HarryXiaoCN/esp32s3-nes-supermini/docs/ui-empty.png

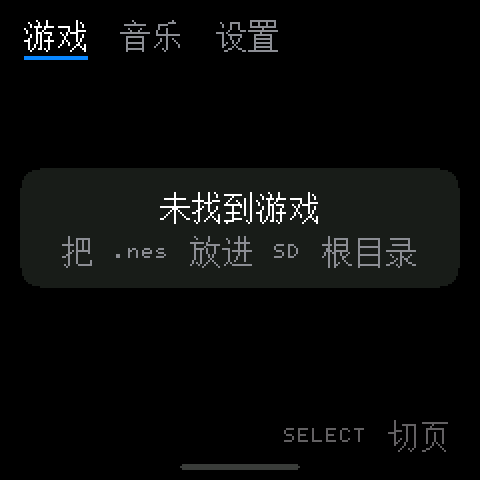
docs/ui-empty.png
