HarryXiaoCN/esp32s3-nes-supermini/docs/ui-lang-en.png

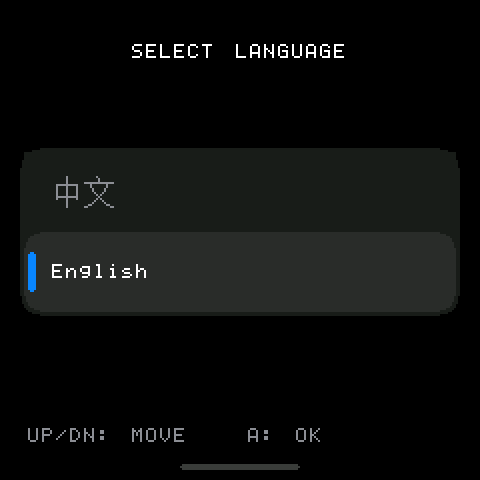
docs/ui-lang-en.png
