HarryXiaoCN/esp32s3-nes-supermini/docs/ui-lang-zh.png

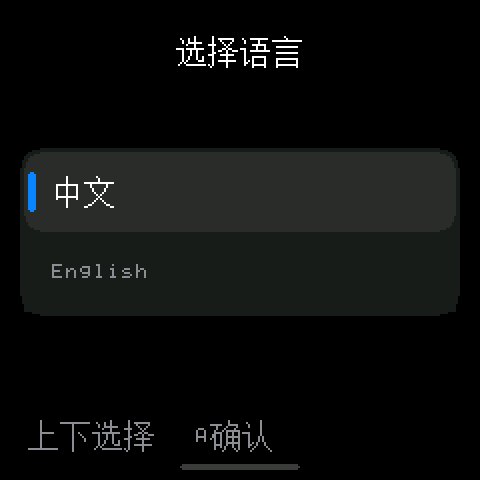
docs/ui-lang-zh.png
