HarryXiaoCN/esp32s3-nes-supermini/docs/ui-menu-en.png

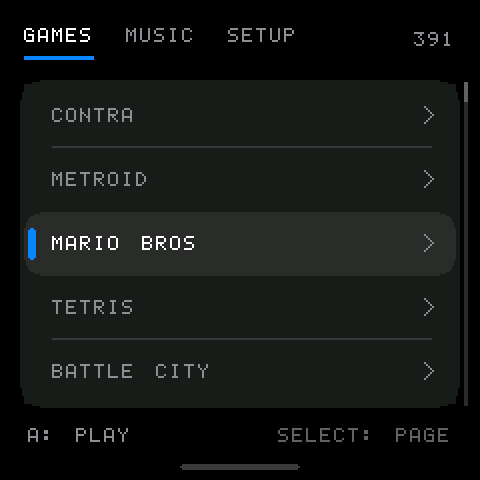
docs/ui-menu-en.png
