HarryXiaoCN/esp32s3-nes-supermini/docs/ui-menu.png

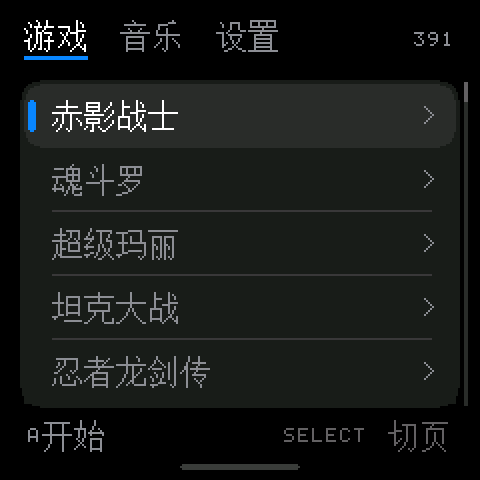
docs/ui-menu.png
