HarryXiaoCN/esp32s3-nes-supermini/docs/ui-music-en.png

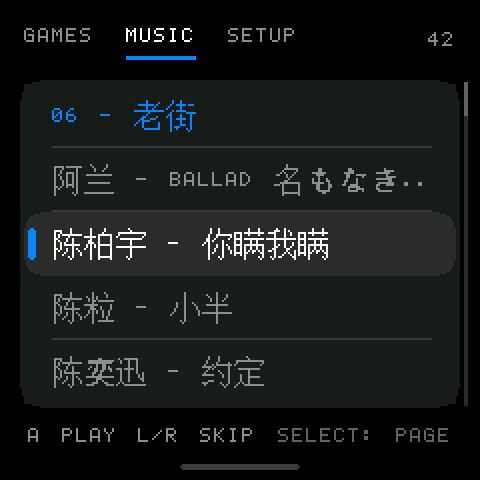
docs/ui-music-en.png
