HarryXiaoCN/esp32s3-nes-supermini/docs/ui-music.png

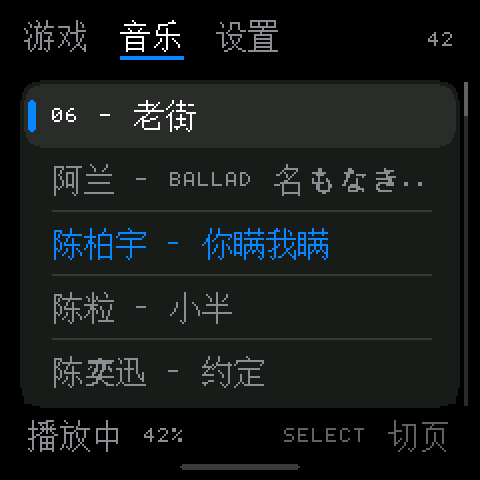
docs/ui-music.png
