HarryXiaoCN/esp32s3-nes-supermini/docs/ui-settings-en.png

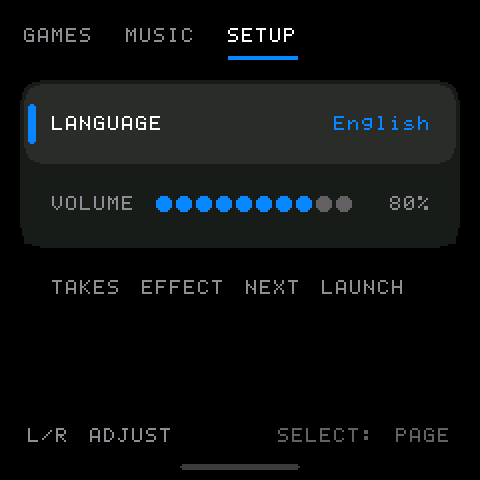
docs/ui-settings-en.png
