HarryXiaoCN/esp32s3-nes-supermini/docs/ui-settings.png

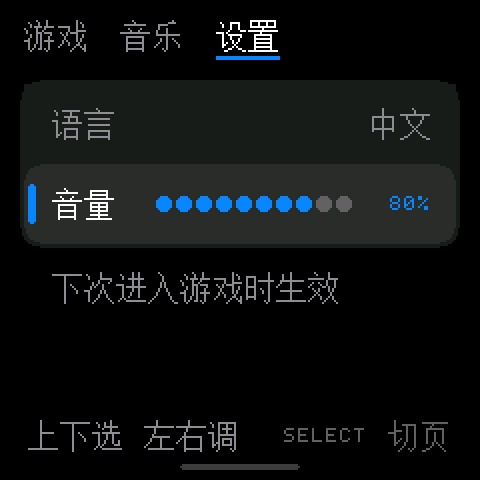
docs/ui-settings.png
