HarryXiaoCN/esp32s3-nes-supermini/docs/ui-sheet.png

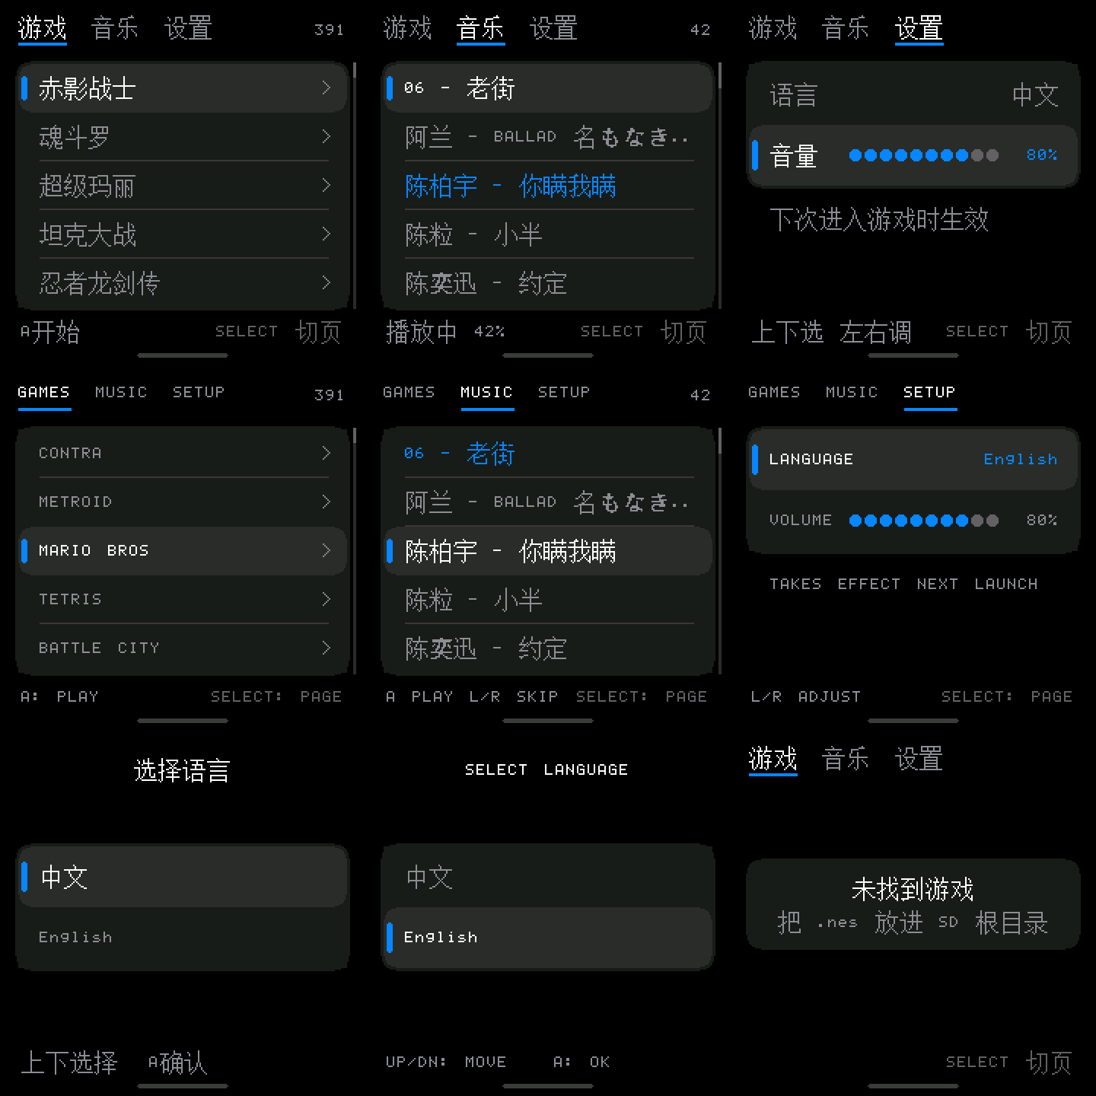
docs/ui-sheet.png
