HarryXiaoCN/esp32s3-nes-supermini/(commit log)

2026-11-09 feat: SD 卡游戏库 + 多页面设置 + I2S 音频 + 开机提速
    - SD 卡挂载：多频率降级重试 + 失败时 CMD0 探测（区分接线/文件系统问题）
    - 游戏列表：按实际 .nes 数量动态分配（PSRAM 优先），无固定上限
    - 设置页：主菜单按 SELECT 进入，可调语言/音量，结果存 NVS
    - 音频：I2S 改立体声帧（修复 MONO 帧导致功放输出直流、喇叭发热）
    - 开机提速：目录扫描改用 getNextFileName（7.7s->0.84s）、动画减步、去掉重复扫描，总计 ~2.6s
    - 修复游戏显示名/路径多一个前导斜杠
    - 文档：HANDOFF/README 记录全部踩坑与环境脱敏
    - tools：字库生成脚本 + 提交前敏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
    [Dsn_nes_Emulator.ino, controller.cpp]
2026-11-09 fix(ui): 取消设置页双重清屏与调值时全屏重绘，减少页面切换闪烁
    - 设置页返回时不再 fillScreen（交给 show_menu 的 needs_full_redraw 统一重绘）
    - 设置页调音/换选项只重绘两行卡片 + 底部提示，不再整屏重绘
    - 底部提示改用背景色覆盖后重写，语言切换时也正确
    [osd.cpp]
2026-11-09 feat: UI 组件化 + 三页页签导航 + MP3 播放器
    ## UI 统一
    - 新增 src/ui_theme.h：颜色/行高/内边距/圆角的唯一来源。改造前三个页面各自
    硬编码，同一个"选中行"的蓝条占行高分别是 56%/36%/45%，文字偏移 y+8/y+9/y+14。
    - osd.cpp 抽出组件层（ui_page_tabs / ui_group / ui_row / ui_page_footer /
    ui_scrollbar / ui_input_poll / ui_page_switch），页面代码不再出现像素常量。
    - 游戏/音乐/设置改成并列的顶层页面，SELECT 向后切、B 向前切；页签画在标题
    那一行（底部 Tab Bar 要吃掉 40px，列表会从 5 行掉到 4 行）。
    ## MP3 播放
    - src/minimp3.h + src/mp3_player.{h,cpp}：SD 读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
2026-11-09 chore(tools): 像素级 UI 模拟器 + MP3 benchmark + 串口写卡工具
    - tools/mock_menu.py：从"用 TrueType 近似画"升级成像素级模拟器。直接解析
    src/cn_font.h 的汉字点阵、src/tft_driver.h 的 font_5x7、src/ui_theme.h 的
    token，按 osd.cpp 组件层的绘制顺序重放，输出与实机一致（含 RGB565 色偏）。
    改 UI 后先跑它看图，满意了再烧板子。
    - tools/mp3_bench/：minimp3 解码速度基准，实测 9.66x 实时 @320kbps。
    （踩坑：font_5x7 解析要先剥行尾注释，否则 ASCII 字模整体错位。）
    - tools/sd_put/：板子 SD 卡不在电脑上时，通过串口把文件写进卡里。
    - tools/extend_cn_font.py：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
2026-11-09 docs: HANDOFF 记录本轮改动 + UI 模拟图
    - HANDOFF 新增第十二/十三节：UI 统一改造（token + 组件层）、顶层页面模型、
    MP3 方案实测数据、字库扩展（3849->7550 字），以及这轮踩过的坑：
    32KB 栈、I2S 所有权转移、音量只存不读、ASCII 整格填充、滚动条漏画。
    - docs/ui-*.png：模拟器生成的九个页面，可直接用于 README。
    - 记录日常迭代方式：只烧 app 分区（0x10000，2.4 秒，不擦 NVS），
    只有改分区表/bootloader 才需要整片 merged.bin。
2026-11-09 docs: 重写 README + 加 GPL-3.0 许可证
    README 从纯接线清单扩充成完整项目说明：特性、硬件、接线、按键用法、
    编译烧录、性能数据、目录结构、已知限制。
    许可证用 GPL-3.0：nofrendo 核心是 GPL，整个项目随之。
    仓库不含 ROM、字体文件和生成的 cn_font.h（见 .gitignore）。
2026-11-11 perf(ui): 翻页/切页不再整块重画 + 屏幕默认 80MHz 可切换
    屏幕：
    - 默认 80MHz（ESP32-S3 SPI 主机上限，ESP-IDF 最高档 SPI_MASTER_FREQ_80M）
    - 设置页新增「屏幕」档 40M/80M，立即生效并写 NVS；切换后整页重绘，
    万一花屏按一下切回 40M 即恢复
    - 开机按住 B = 强制 40MHz（不看屏幕也能从花屏恢复的唯一路径）
    - 游戏画面走同一条总线：单帧传输 23ms -> 11.5ms，理论帧率上限 43 -> 60fps
    绘制（40MHz 下按 mock 重放的真实绘制顺序统计）：
    - 翻页：跳过没变的卡片底，非选中行只清 16px 文字带，154KB -> 51KB
    （30.8ms -> 10.3ms 下界）
    - 切页签：ui_page_ta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
2026-11-11 docs: 记录 GitHub 推送必须走 SOCKS5 代理（HTTP 代理会 408）
